bevinkbd/miscellaneous-calla/README.md

# miscellaneous-calla
for all your calla needs
