bevinkbd/miscellaneous-calla/plates/custom_plates/README.md

# group buy plates

thicknesses:
MX - 1.5 mm
Topre - 1.2 mm
Alps - 1.2 mm

sanity check:
346.125 mm x 129.325 mm for all plates

before you proceed please note: files are provided as is. these files are made by request and have not been prototyped. ensure that the layout and orientation of your keys/stabilizers are correct. use at your own risk.

if you are unsure about the compatibility of a file, I would be more than glad to help.
