bevinkbd/miscellaneous-calla/plates/group_buy_plates/README.md

# group buy plates

metal MX - 1.5 mm 5053 aluminium
plastic MX - 1.5 mm polypropylene
metal Topre - 1.2 mm stainless steel. WARNING: requires 43x M2 tapped holes.

sanity check:
346.125 mm x 129.325 mm for all plates
