bevinkbd/miscellaneous-calla/misc/foam.dxf

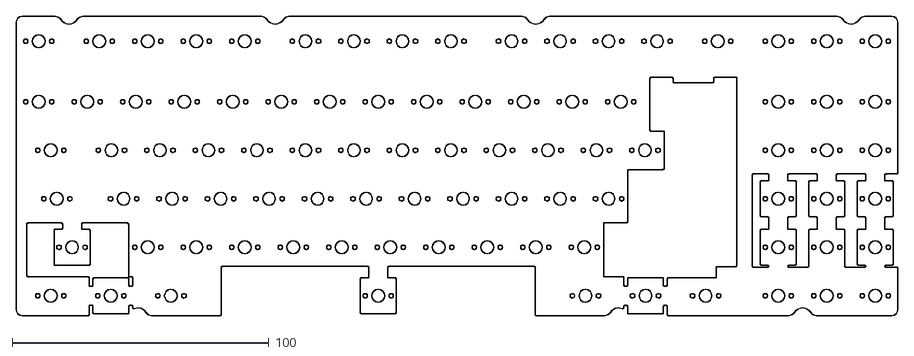
[picture p1: CAD file, 2024-04-25]
misc/foam.dxf
343.6 x 116.6
