bevinkbd/miscellaneous-calla/plates/custom_plates/alps/alps_2023_08_19_splitrs+split_bs.dxf

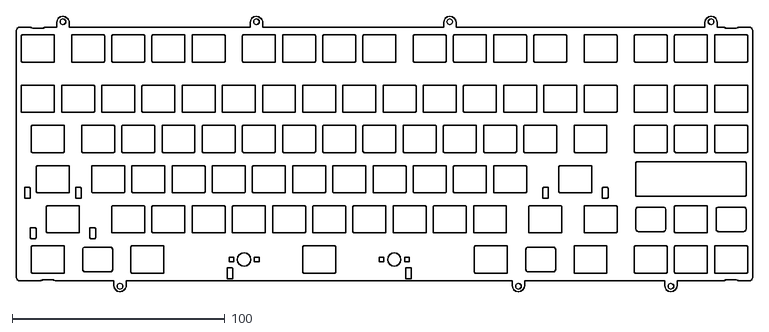
[picture p2: CAD file, 2024-04-28]
plates/custom_plates/alps/alps_2023_08_19_splitrs+split_bs.dxf
346.1 x 129.3
