bevinkbd/miscellaneous-calla/plates/custom_plates/topre/metal_topre_2023_08_19_splitBS+splitRS.dxf

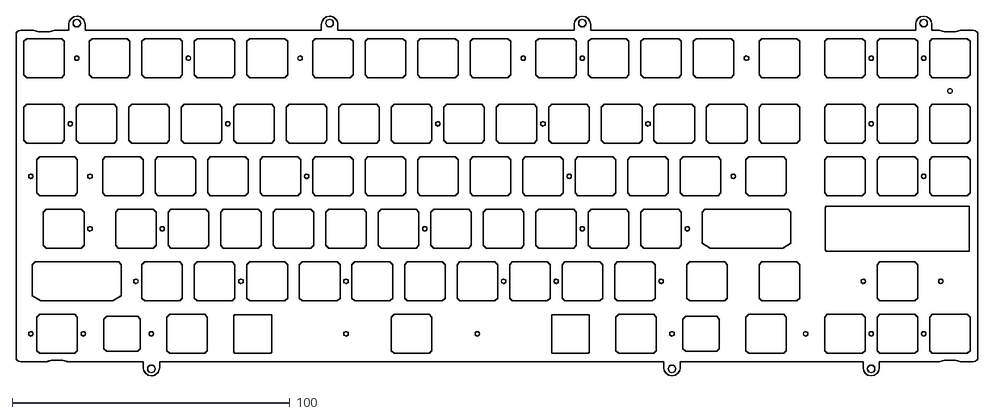
[picture p3: CAD file, 2024-04-28]
plates/custom_plates/topre/metal_topre_2023_08_19_splitBS+splitRS.dxf
346.1 x 129.3
