bevinkbd/miscellaneous-calla/plates/group_buy_plates/metal_MX_2023_08_19.dxf

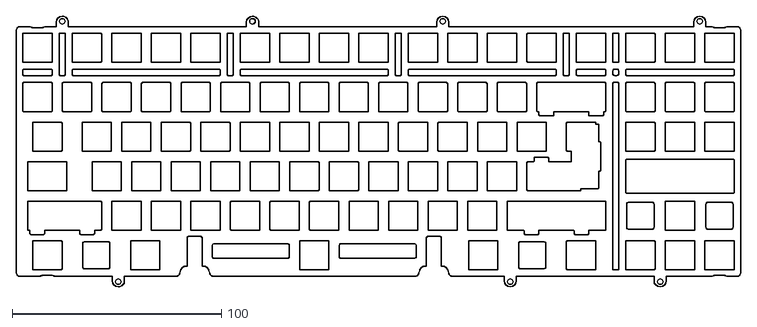
[picture p4: CAD file, 2024-04-25]
plates/group_buy_plates/metal_MX_2023_08_19.dxf
346.1 x 129.3
