bevinkbd/miscellaneous-calla/plates/custom_plates/alps/alps_2023_08_19.dxf

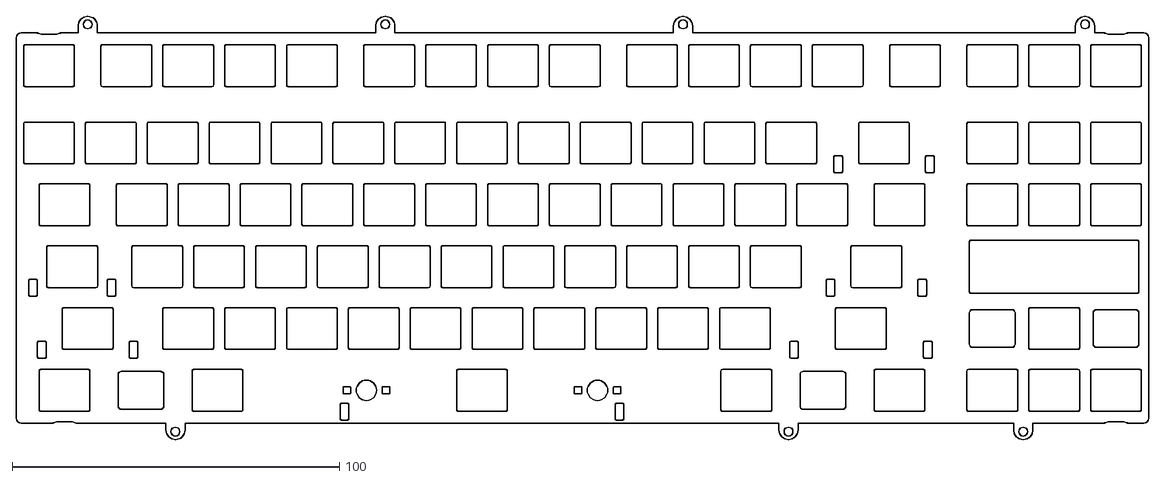
[picture p5: CAD file, 2024-04-28]
plates/custom_plates/alps/alps_2023_08_19.dxf
346.1 x 129.3
