bevinkbd/miscellaneous-calla/plates/custom_plates/topre/metal_topre_2023_08_19_splitBS.dxf

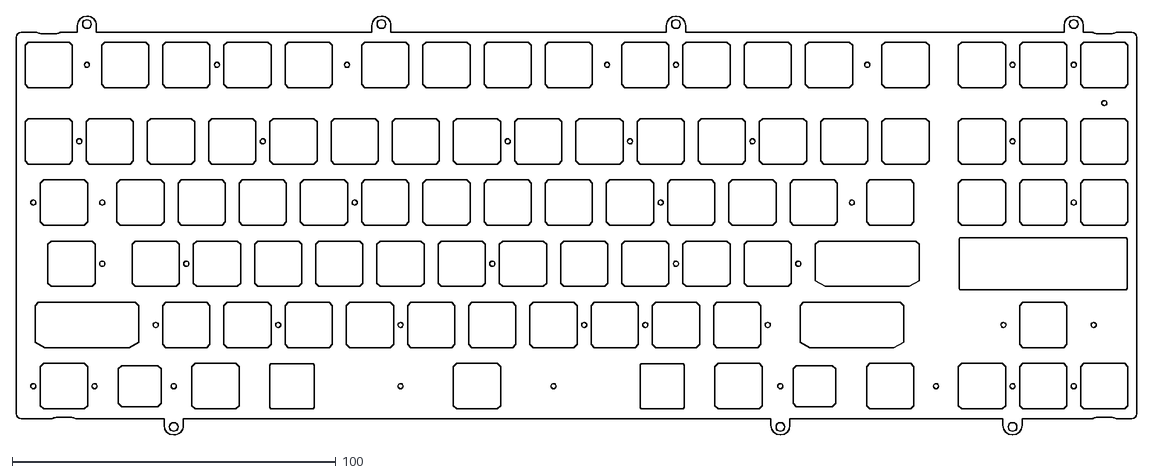
[picture p6: CAD file, 2024-04-28]
plates/custom_plates/topre/metal_topre_2023_08_19_splitBS.dxf
346.1 x 129.3
