bevinkbd/miscellaneous-calla/pcbs/eccalla/EC_Rev2.kicad_sch

## KiCad design pcbs/eccalla/EC_Rev2.kicad_sch (2024-04-25)

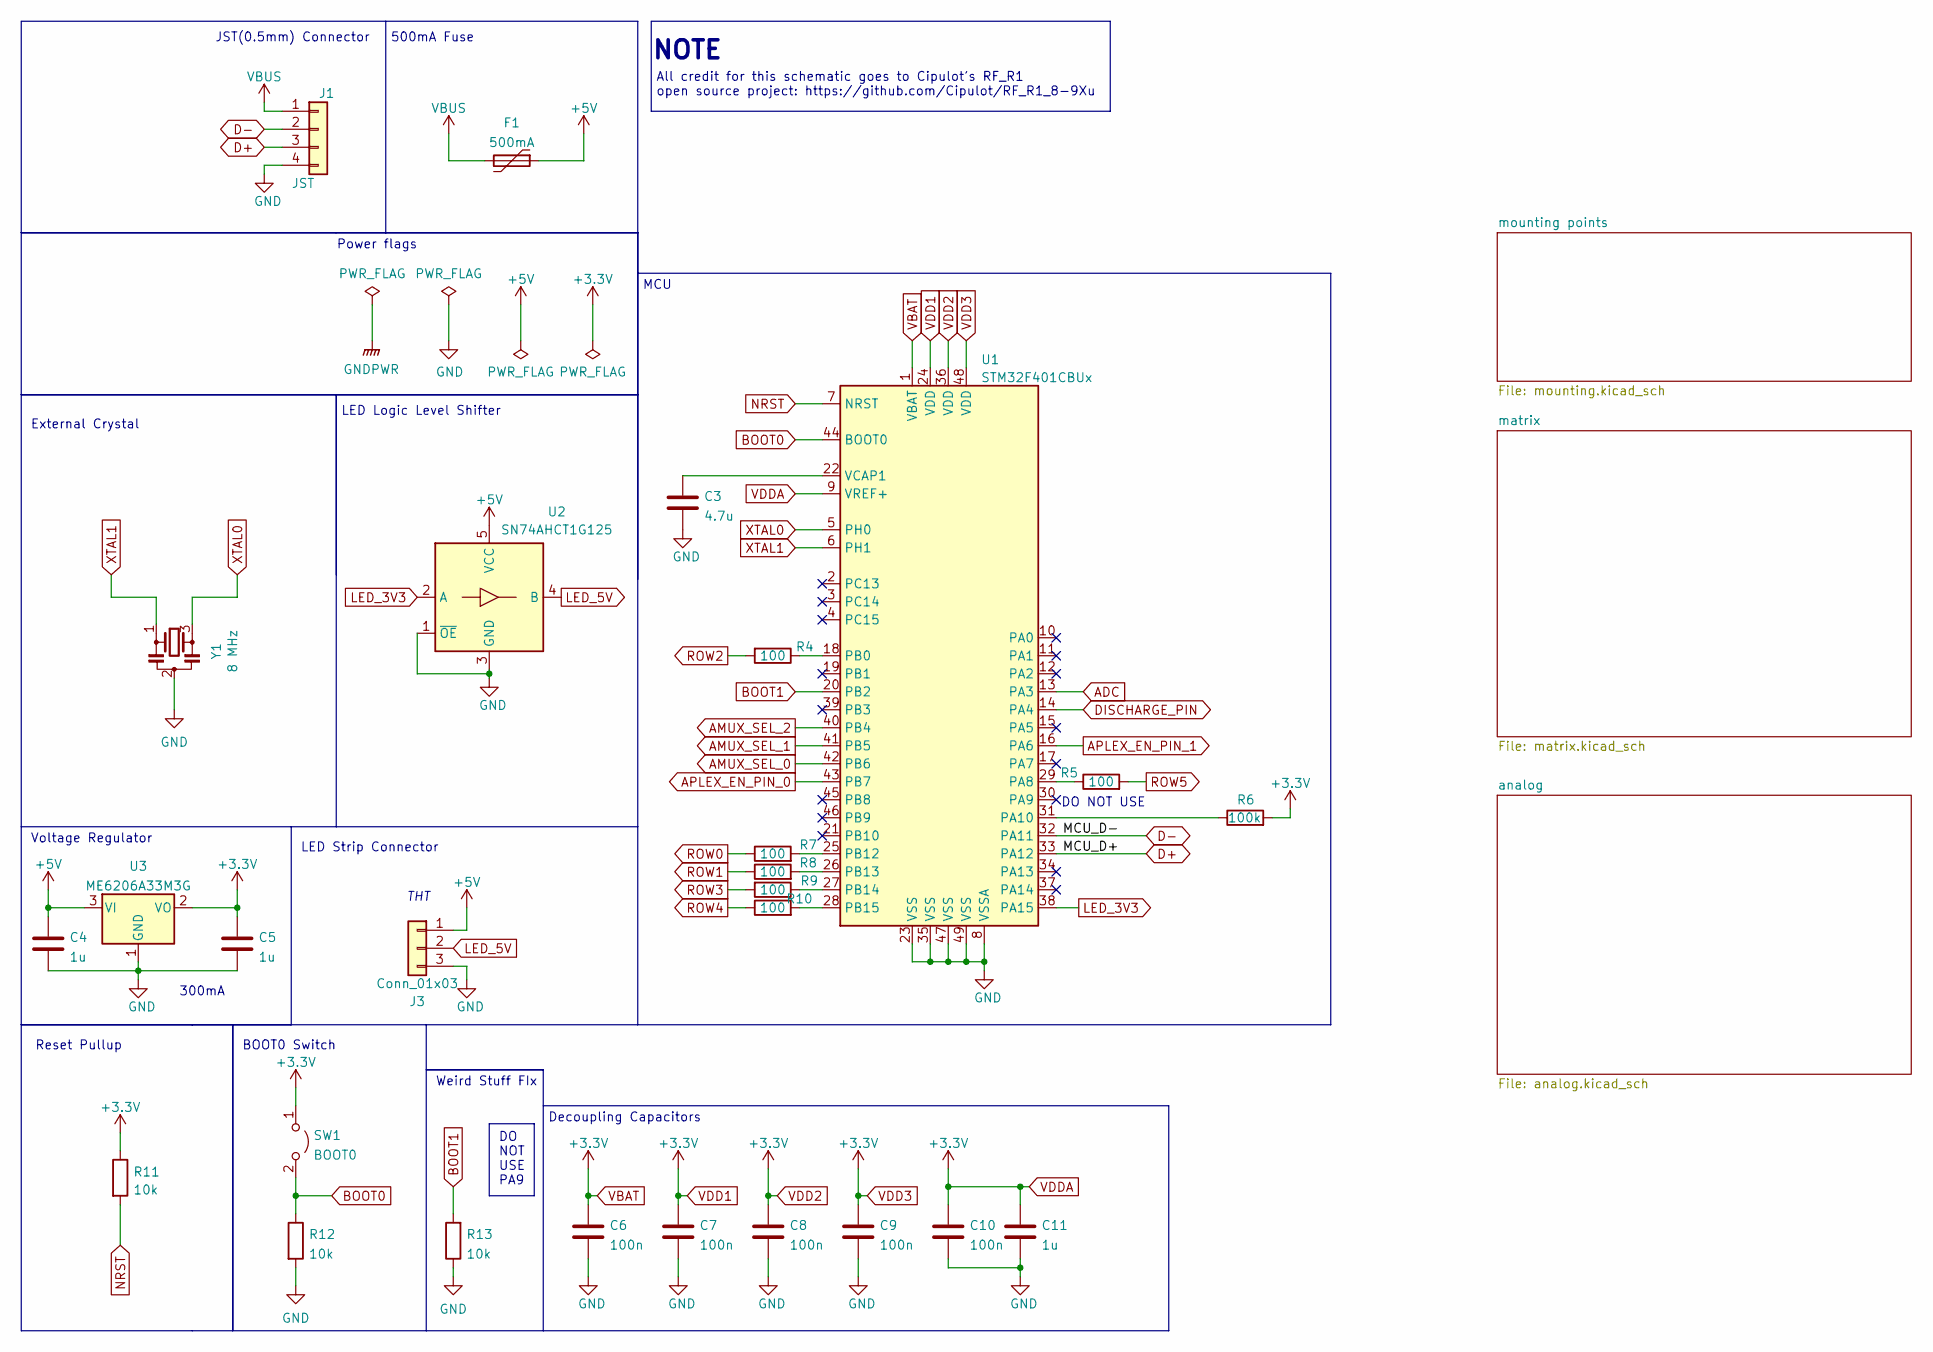
[picture p15: schematic EC_Rev2.kicad_sch]

Parts:
C3: 4.7u; C_0402_1005Metric; LCSC C23733
C4, C5, C11: 1u; C_0402_1005Metric; LCSC C52923
C6, C7, C8, C9, C10: 100n; C_0402_1005Metric; LCSC C307331
F1: 500mA; Fuse_1206_3216Metric; LCSC C70076
J1: JST; JST-SR-4; LCSC C145956
J3: Conn_01x03; PinHeader_1x03_P2.54mm_Vertical
R4, R5, R7, R8, R9, R10: 100; R_0402_1005Metric; LCSC C25076
R6: 100k; R_0402_1005Metric; LCSC C25741
R11, R12, R13: 10k; R_0402_1005Metric; LCSC C25744
SW1: BOOT0; PinHeader_1x02_P1.27mm_Vertical
U1: STM32F401CBUx; QFN-48-1EP_7x7mm_P0.5mm_EP5.6x5.6mm; LCSC C118825
U2: SN74AHCT1G125; SOT-23-5; LCSC C7484
U3: ME6206A33M3G; SOT-23; LCSC C35259
Y1: 8 MHz; Resonator_SMD_Murata_CSTxExxV-3Pin_3.0x1.1mm; LCSC C907975

Connections:
+3.3V: C5.1, C6.1, C7.1, C8.1, C9.1, C10.1, C11.1, R6.2, R11.1, SW1.1 (A), U1.1 (VBAT), U1.9 (VREF+), U1.24 (VDD), U1.36 (VDD), U1.48 (VDD), U3.2 (VO)
+5V: C4.1, F1.1, J3.1, U2.5 (VCC), U3.3 (VI)
ADC: U1.13 (PA3)
AMUX_SEL_0: U1.42 (PB6)
AMUX_SEL_1: U1.41 (PB5)
AMUX_SEL_2: U1.40 (PB4)
APLEX_EN_PIN_0: U1.43 (PB7)
APLEX_EN_PIN_1: U1.16 (PA6)
BOOT0: R12.1, SW1.2 (B), U1.44 (BOOT0)
BOOT1: R13.2, U1.20 (PB2)
D+: J1.3, U1.33 (PA12)
D-: J1.2, U1.32 (PA11)
DISCHARGE_PIN: U1.14 (PA4)
GND: C3.2, C4.2, C5.2, C6.2, C7.2, C8.2, C9.2, C10.2, C11.2, J1.4, J3.3, R12.2, R13.1, U1.8 (VSSA), U1.23 (VSS), U1.35 (VSS), U1.47 (VSS), U1.49 (VSS), U2.1 (~OE), U2.3 (GND), U3.1 (GND), Y1.2
LED_3V3: U1.38 (PA15), U2.2 (A)
LED_5V: J3.2, U2.4 (B)
NRST: R11.2, U1.7 (NRST)
unnamed: C3.1, U1.22 (VCAP1)
unnamed: R4.1, U1.18 (PB0)
unnamed: R5.1, U1.29 (PA8)
unnamed: R6.1, U1.31 (PA10)
unnamed: R7.2, U1.25 (PB12)
unnamed: R8.2, U1.26 (PB13)
unnamed: R9.1, U1.27 (PB14)
unnamed: R10.2, U1.28 (PB15)
ROW0: R7.1
ROW1: R8.1
ROW2: R4.2
ROW3: R9.2
ROW4: R10.1
ROW5: R5.2
VBUS: F1.2, J1.1
XTAL0: U1.5 (PH0), Y1.3
XTAL1: U1.6 (PH1), Y1.1

Notes on the sheet:
LED Strip Connector
300mA
Weird Stuff FIx
JST(0.5mm) Connector
Decoupling Capacitors
MCU
THT
All credit for this schematic goes to Cipulot's RF_R1 open source project: https://github.com/Cipulot/RF_R1_8-9Xu
DO NOT USE PA9
External Crystal
500mA Fuse
NOTE
Power flags
Voltage Regulator
BOOT0 Switch
LED Logic Level Shifter
Reset Pullup
DO NOT USE
