bevinkbd/miscellaneous-calla/pcbs/eccalla/analog.kicad_sch

## KiCad design pcbs/eccalla/analog.kicad_sch (2024-04-25)

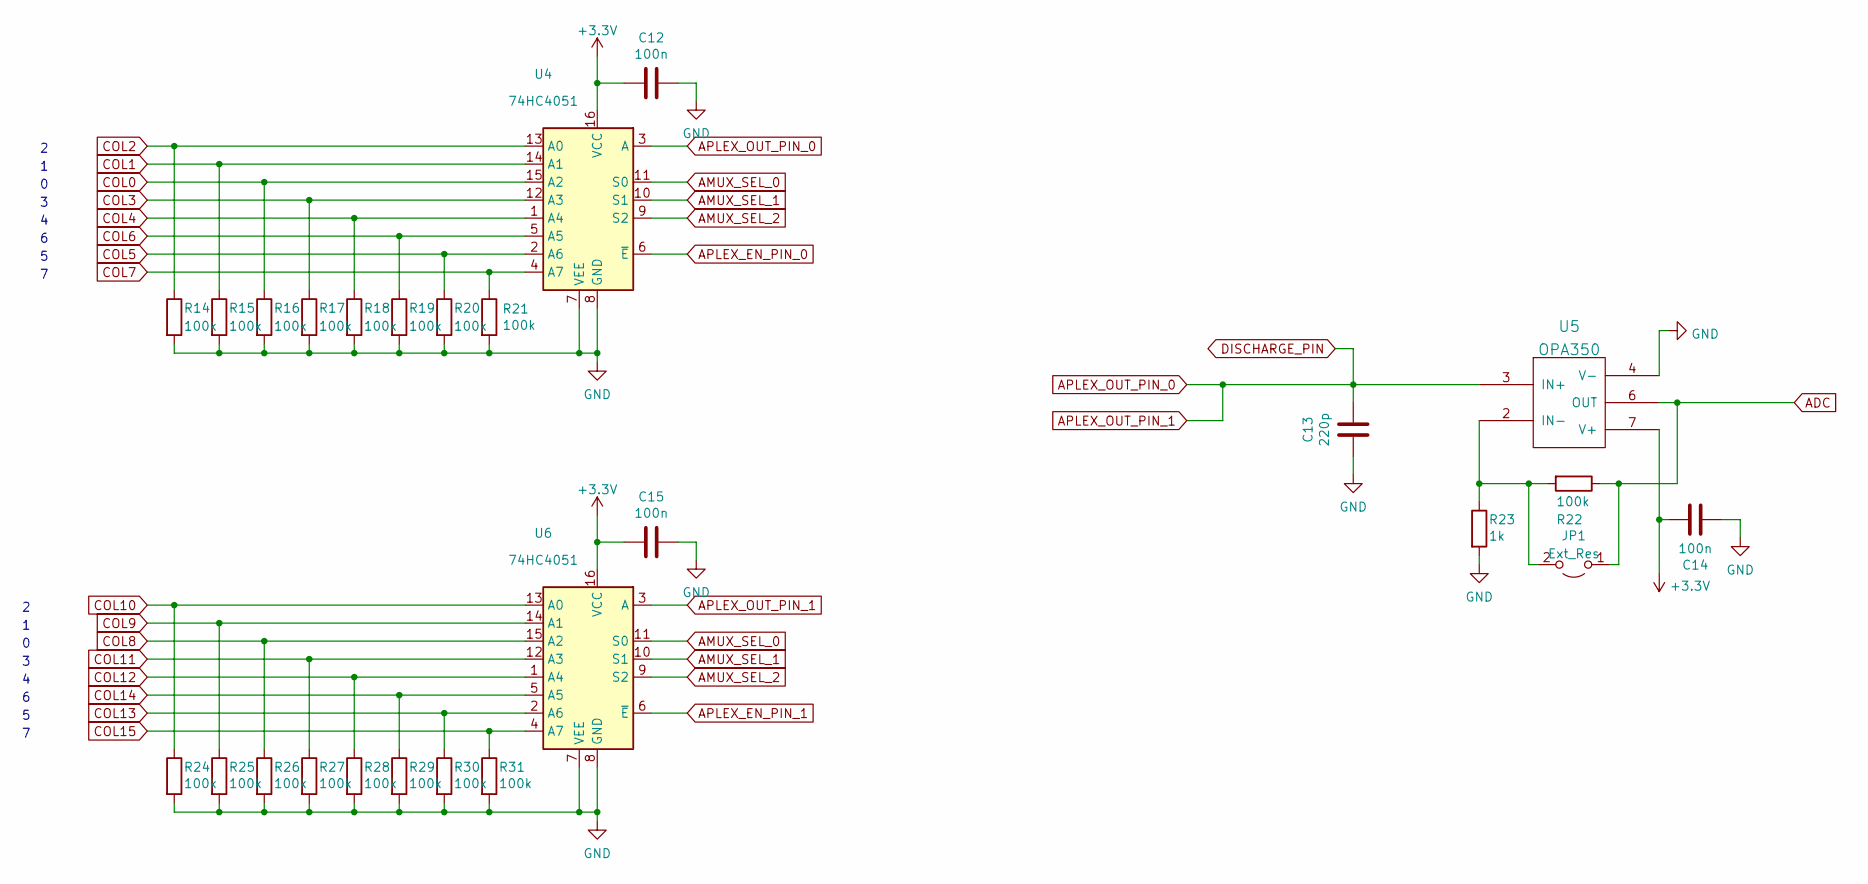
[picture p16: schematic analog.kicad_sch]

Parts:
C12, C14, C15: 100n; C_0402_1005Metric; LCSC C307331
C13: 220p; C_0603_1608Metric; LCSC C1603
JP1: Ext_Res; R_0603_1608Metric
R14, R15, R16, R17, R18, R19, R20, R21, R24, R25, R26, R27, R28, R29, R30, R31: 100k; R_0402_1005Metric; LCSC C25741
R22: 100k; R_0603_1608Metric; LCSC C25803
R23: 1k; R_0603_1608Metric; LCSC C21190
U4, U6: 74HC4051; TSSOP16; LCSC C5645
U5: OPA350; SOIC-8_3.9x4.9mm_P1.27mm; LCSC C13388

Connections:
+3.3V: C12.2, C14.2, C15.2, U4.16 (VCC), U5.7 (V+), U6.16 (VCC)
ADC: JP1.1 (A), R22.1, U5.6 (OUT)
AMUX_SEL_0: U4.11 (S0), U6.11 (S0)
AMUX_SEL_1: U4.10 (S1), U6.10 (S1)
AMUX_SEL_2: U4.9 (S2), U6.9 (S2)
APLEX_EN_PIN_0: U4.6 (~E)
APLEX_EN_PIN_1: U6.6 (~E)
APLEX_OUT_PIN_0: C13.1, U4.3 (A), U5.3 (IN+), U6.3 (A)
COL0: R16.1, U4.15 (A2)
COL1: R15.1, U4.14 (A1)
COL2: R14.1, U4.13 (A0)
COL3: R17.1, U4.12 (A3)
COL4: R18.1, U4.1 (A4)
COL5: R20.1, U4.2 (A6)
COL6: R19.1, U4.5 (A5)
COL7: R21.1, U4.4 (A7)
COL8: R26.1, U6.15 (A2)
COL9: R25.1, U6.14 (A1)
COL10: R24.1, U6.13 (A0)
COL11: R27.1, U6.12 (A3)
COL12: R28.1, U6.1 (A4)
COL13: R30.1, U6.2 (A6)
COL14: R29.1, U6.5 (A5)
COL15: R31.1, U6.4 (A7)
GND: C12.1, C13.2, C14.1, C15.1, R14.2, R15.2, R16.2, R17.2, R18.2, R19.2, R20.2, R21.2, R23.2, R24.2, R25.2, R26.2, R27.2, R28.2, R29.2, R30.2, R31.2, U4.7 (VEE), U4.8 (GND), U5.4 (V-), U6.7 (VEE), U6.8 (GND)
unnamed: JP1.2 (B), R22.2, R23.1, U5.2 (IN-)
