bevinkbd/miscellaneous-calla/pcbs/eccalla/matrix.kicad_sch

## KiCad design pcbs/eccalla/matrix.kicad_sch (2024-04-25)

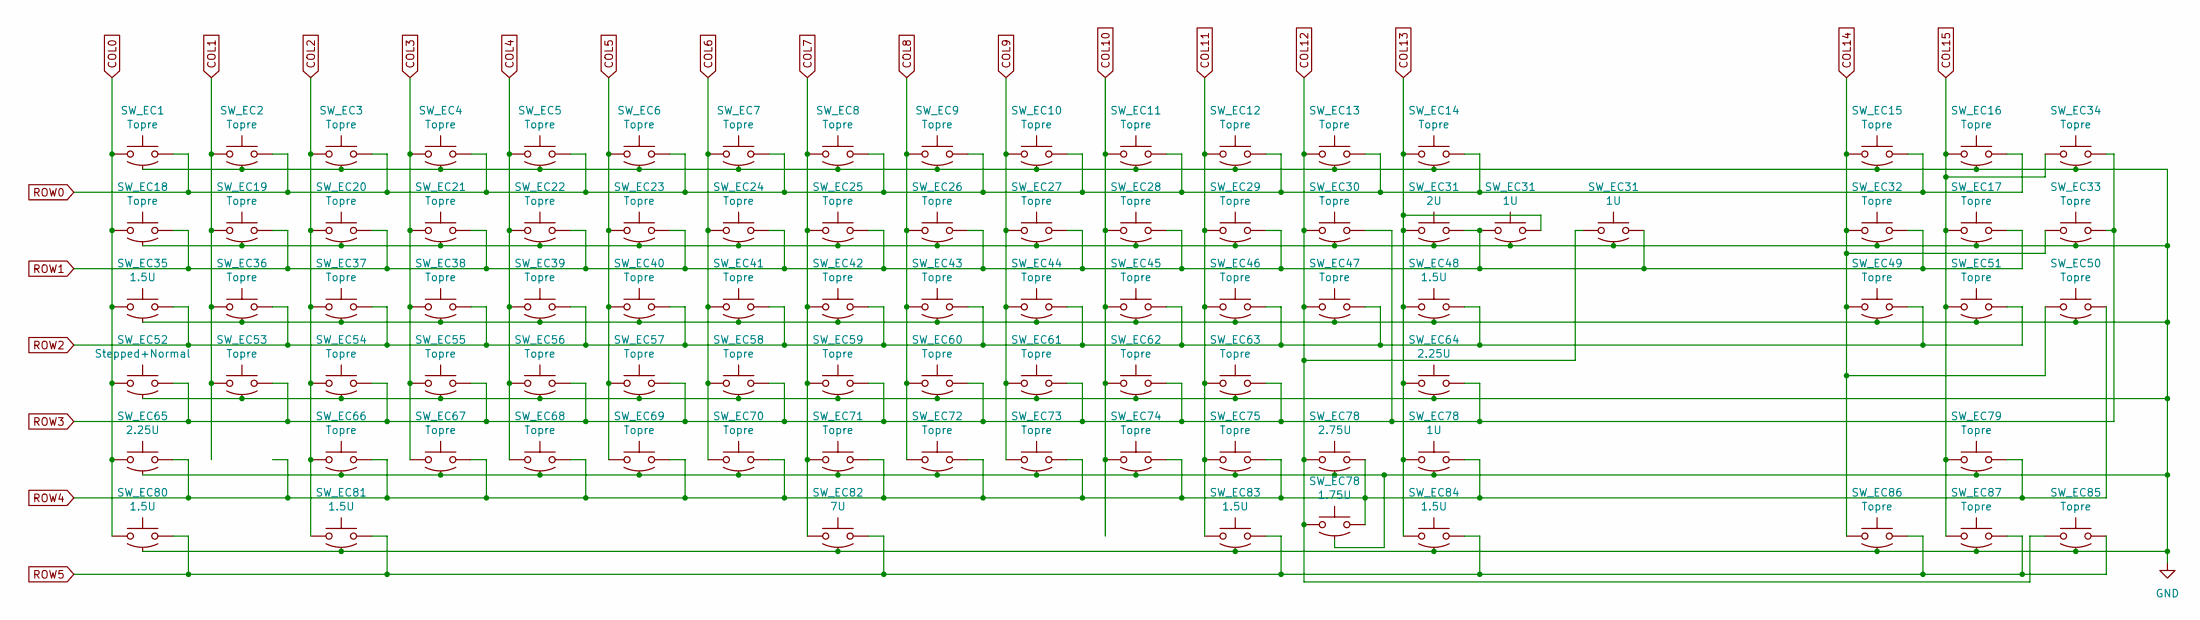
[picture p17: schematic matrix.kicad_sch]

Parts:
SW_EC1, SW_EC2, SW_EC3, SW_EC4, SW_EC5, SW_EC6, SW_EC7, SW_EC8, SW_EC9, SW_EC10, SW_EC11, SW_EC12, SW_EC13, SW_EC14, SW_EC15, SW_EC16, SW_EC17, SW_EC18, SW_EC19, SW_EC20, SW_EC21, SW_EC22, SW_EC23, SW_EC24, SW_EC25, SW_EC26, SW_EC27, SW_EC28, SW_EC29, SW_EC30, SW_EC32, SW_EC33, SW_EC34, SW_EC36, SW_EC37, SW_EC38, SW_EC39, SW_EC40, SW_EC41, SW_EC42, SW_EC43, SW_EC44, SW_EC45, SW_EC46, SW_EC47, SW_EC49, SW_EC50, SW_EC51, SW_EC53, SW_EC54, SW_EC55, SW_EC56, SW_EC57, SW_EC58, SW_EC59, SW_EC60, SW_EC61, SW_EC62, SW_EC63, SW_EC66, SW_EC67, SW_EC68, SW_EC69, SW_EC70, SW_EC71, SW_EC72, SW_EC73, SW_EC74, SW_EC75, SW_EC79, SW_EC85, SW_EC86, SW_EC87: Topre; ecs_pad_1U_no_ring
SW_EC31, SW_EC78: 1U; ecs_pad_1U_no_ring
SW_EC35, SW_EC48, SW_EC80, SW_EC81, SW_EC83, SW_EC84: 1.5U; ecs_pad_1.5U_no_ring
SW_EC52: Stepped+Normal; ecs_pad_no_ring_stepped&normal
SW_EC64, SW_EC65: 2.25U; ecs_pad_2.25U_no_ring
SW_EC82: 7U; ecs_pad_7U_no_ring

Connections:
COL0: SW_EC1.1, SW_EC18.1, SW_EC35.1, SW_EC52.1, SW_EC65.1, SW_EC80.1
COL1: SW_EC2.1, SW_EC19.1, SW_EC36.1, SW_EC53.1
COL2: SW_EC3.1, SW_EC20.1, SW_EC37.1, SW_EC54.1, SW_EC66.1, SW_EC81.1
COL3: SW_EC4.1, SW_EC21.1, SW_EC38.1, SW_EC55.1, SW_EC67.1
COL4: SW_EC5.1, SW_EC22.1, SW_EC39.1, SW_EC56.1, SW_EC68.1
COL5: SW_EC6.1, SW_EC23.1, SW_EC40.1, SW_EC57.1, SW_EC69.1
COL6: SW_EC7.1, SW_EC24.1, SW_EC41.1, SW_EC58.1, SW_EC70.1
COL7: SW_EC8.1, SW_EC25.1, SW_EC42.1, SW_EC59.1, SW_EC71.1, SW_EC82.1
COL8: SW_EC9.1, SW_EC26.1, SW_EC43.1, SW_EC60.1, SW_EC72.1
COL9: SW_EC10.1, SW_EC27.1, SW_EC44.1, SW_EC61.1, SW_EC73.1
COL10: SW_EC11.1, SW_EC28.1, SW_EC45.1, SW_EC62.1, SW_EC74.1
COL11: SW_EC12.1, SW_EC29.1, SW_EC46.1, SW_EC63.1, SW_EC75.1, SW_EC83.1
COL12: SW_EC13.1, SW_EC30.1, SW_EC31.1, SW_EC47.1, SW_EC78.1, SW_EC85.1
COL13: SW_EC14.1, SW_EC31.1, SW_EC31.2, SW_EC48.1, SW_EC64.1, SW_EC78.1, SW_EC84.1
COL14: SW_EC15.1, SW_EC32.1, SW_EC33.1, SW_EC49.1, SW_EC50.1, SW_EC86.1
COL15: SW_EC16.1, SW_EC17.1, SW_EC34.1, SW_EC51.1, SW_EC79.1, SW_EC87.1
GND: SW_EC1.3, SW_EC2.3, SW_EC3.3, SW_EC4.3, SW_EC5.3, SW_EC6.3, SW_EC7.3, SW_EC8.3, SW_EC9.3, SW_EC10.3, SW_EC11.3, SW_EC12.3, SW_EC13.3, SW_EC14.3, SW_EC15.3, SW_EC16.3, SW_EC17.3, SW_EC18.3, SW_EC19.3, SW_EC20.3, SW_EC21.3, SW_EC22.3, SW_EC23.3, SW_EC24.3, SW_EC25.3, SW_EC26.3, SW_EC27.3, SW_EC28.3, SW_EC29.3, SW_EC30.3, SW_EC31.3, SW_EC32.3, SW_EC33.3, SW_EC34.3, SW_EC35.3, SW_EC36.3, SW_EC37.3, SW_EC38.3, SW_EC39.3, SW_EC40.3, SW_EC41.3, SW_EC42.3, SW_EC43.3, SW_EC44.3, SW_EC45.3, SW_EC46.3, SW_EC47.3, SW_EC48.3, SW_EC49.3, SW_EC50.3, SW_EC51.3, SW_EC52.3, SW_EC53.3, SW_EC54.3, SW_EC55.3, SW_EC56.3, SW_EC57.3, SW_EC58.3, SW_EC59.3, SW_EC60.3, SW_EC61.3, SW_EC62.3, SW_EC63.3, SW_EC64.3, SW_EC65.3, SW_EC66.3, SW_EC67.3, SW_EC68.3, SW_EC69.3, SW_EC70.3, SW_EC71.3, SW_EC72.3, SW_EC73.3, SW_EC74.3, SW_EC75.3, SW_EC78.3, SW_EC79.3, SW_EC80.3, SW_EC81.3, SW_EC82.3, SW_EC83.3, SW_EC84.3, SW_EC85.3, SW_EC86.3, SW_EC87.3
ROW0: SW_EC1.2, SW_EC2.2, SW_EC3.2, SW_EC4.2, SW_EC5.2, SW_EC6.2, SW_EC7.2, SW_EC8.2, SW_EC9.2, SW_EC10.2, SW_EC11.2, SW_EC12.2, SW_EC13.2, SW_EC14.2, SW_EC15.2, SW_EC16.2
ROW1: SW_EC17.2, SW_EC18.2, SW_EC19.2, SW_EC20.2, SW_EC21.2, SW_EC22.2, SW_EC23.2, SW_EC24.2, SW_EC25.2, SW_EC26.2, SW_EC27.2, SW_EC28.2, SW_EC29.2, SW_EC31.1, SW_EC31.2, SW_EC32.2
ROW2: SW_EC35.2, SW_EC36.2, SW_EC37.2, SW_EC38.2, SW_EC39.2, SW_EC40.2, SW_EC41.2, SW_EC42.2, SW_EC43.2, SW_EC44.2, SW_EC45.2, SW_EC46.2, SW_EC47.2, SW_EC48.2, SW_EC49.2, SW_EC51.2
ROW3: SW_EC30.2, SW_EC33.2, SW_EC34.2, SW_EC52.2, SW_EC53.2, SW_EC54.2, SW_EC55.2, SW_EC56.2, SW_EC57.2, SW_EC58.2, SW_EC59.2, SW_EC60.2, SW_EC61.2, SW_EC62.2, SW_EC63.2, SW_EC64.2
ROW4: SW_EC50.2, SW_EC65.2, SW_EC66.2, SW_EC67.2, SW_EC68.2, SW_EC69.2, SW_EC70.2, SW_EC71.2, SW_EC72.2, SW_EC73.2, SW_EC74.2, SW_EC75.2, SW_EC78.2, SW_EC79.2
ROW5: SW_EC80.2, SW_EC81.2, SW_EC82.2, SW_EC83.2, SW_EC84.2, SW_EC85.2, SW_EC86.2, SW_EC87.2
