bevinkbd/miscellaneous-calla/pcbs/eccalla/mounting.kicad_sch

## KiCad design pcbs/eccalla/mounting.kicad_sch (2024-04-25)

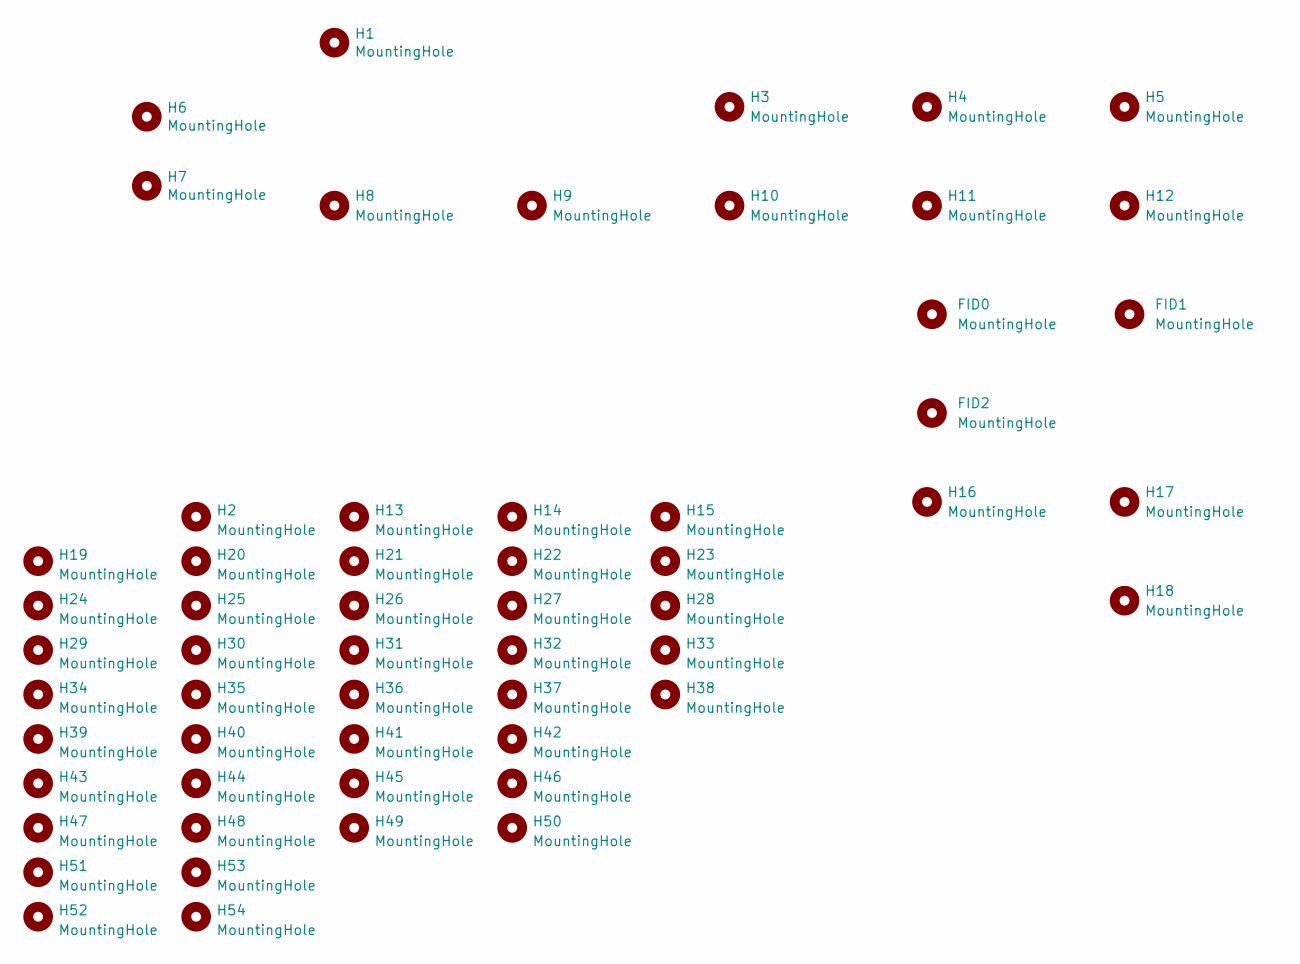
[picture p18: schematic mounting.kicad_sch]

Parts:
FID0, FID1, FID2: MountingHole; Fiducial_1.5mm_Mask3mm
H1: MountingHole; xcalla
H2, H13, H14, H15, H16, H17, H18, H19, H20, H21, H22, H23, H24, H25, H26, H27, H28, H29, H30, H31, H32, H33, H34, H35, H36, H37, H38, H39, H40, H41, H42, H43, H44, H45, H46, H47, H48, H49, H50, H51, H52, H53, H54: MountingHole; M2 screwhole
H3, H4, H5, H6, H7, H8, H9, H10, H11, H12: MountingHole; breakaway-mousebites
