bevinkbd/miscellaneous-calla/pcbs/hscalla/hscalla.kicad_sch

## KiCad design pcbs/hscalla/hscalla.kicad_sch (2024-04-25)

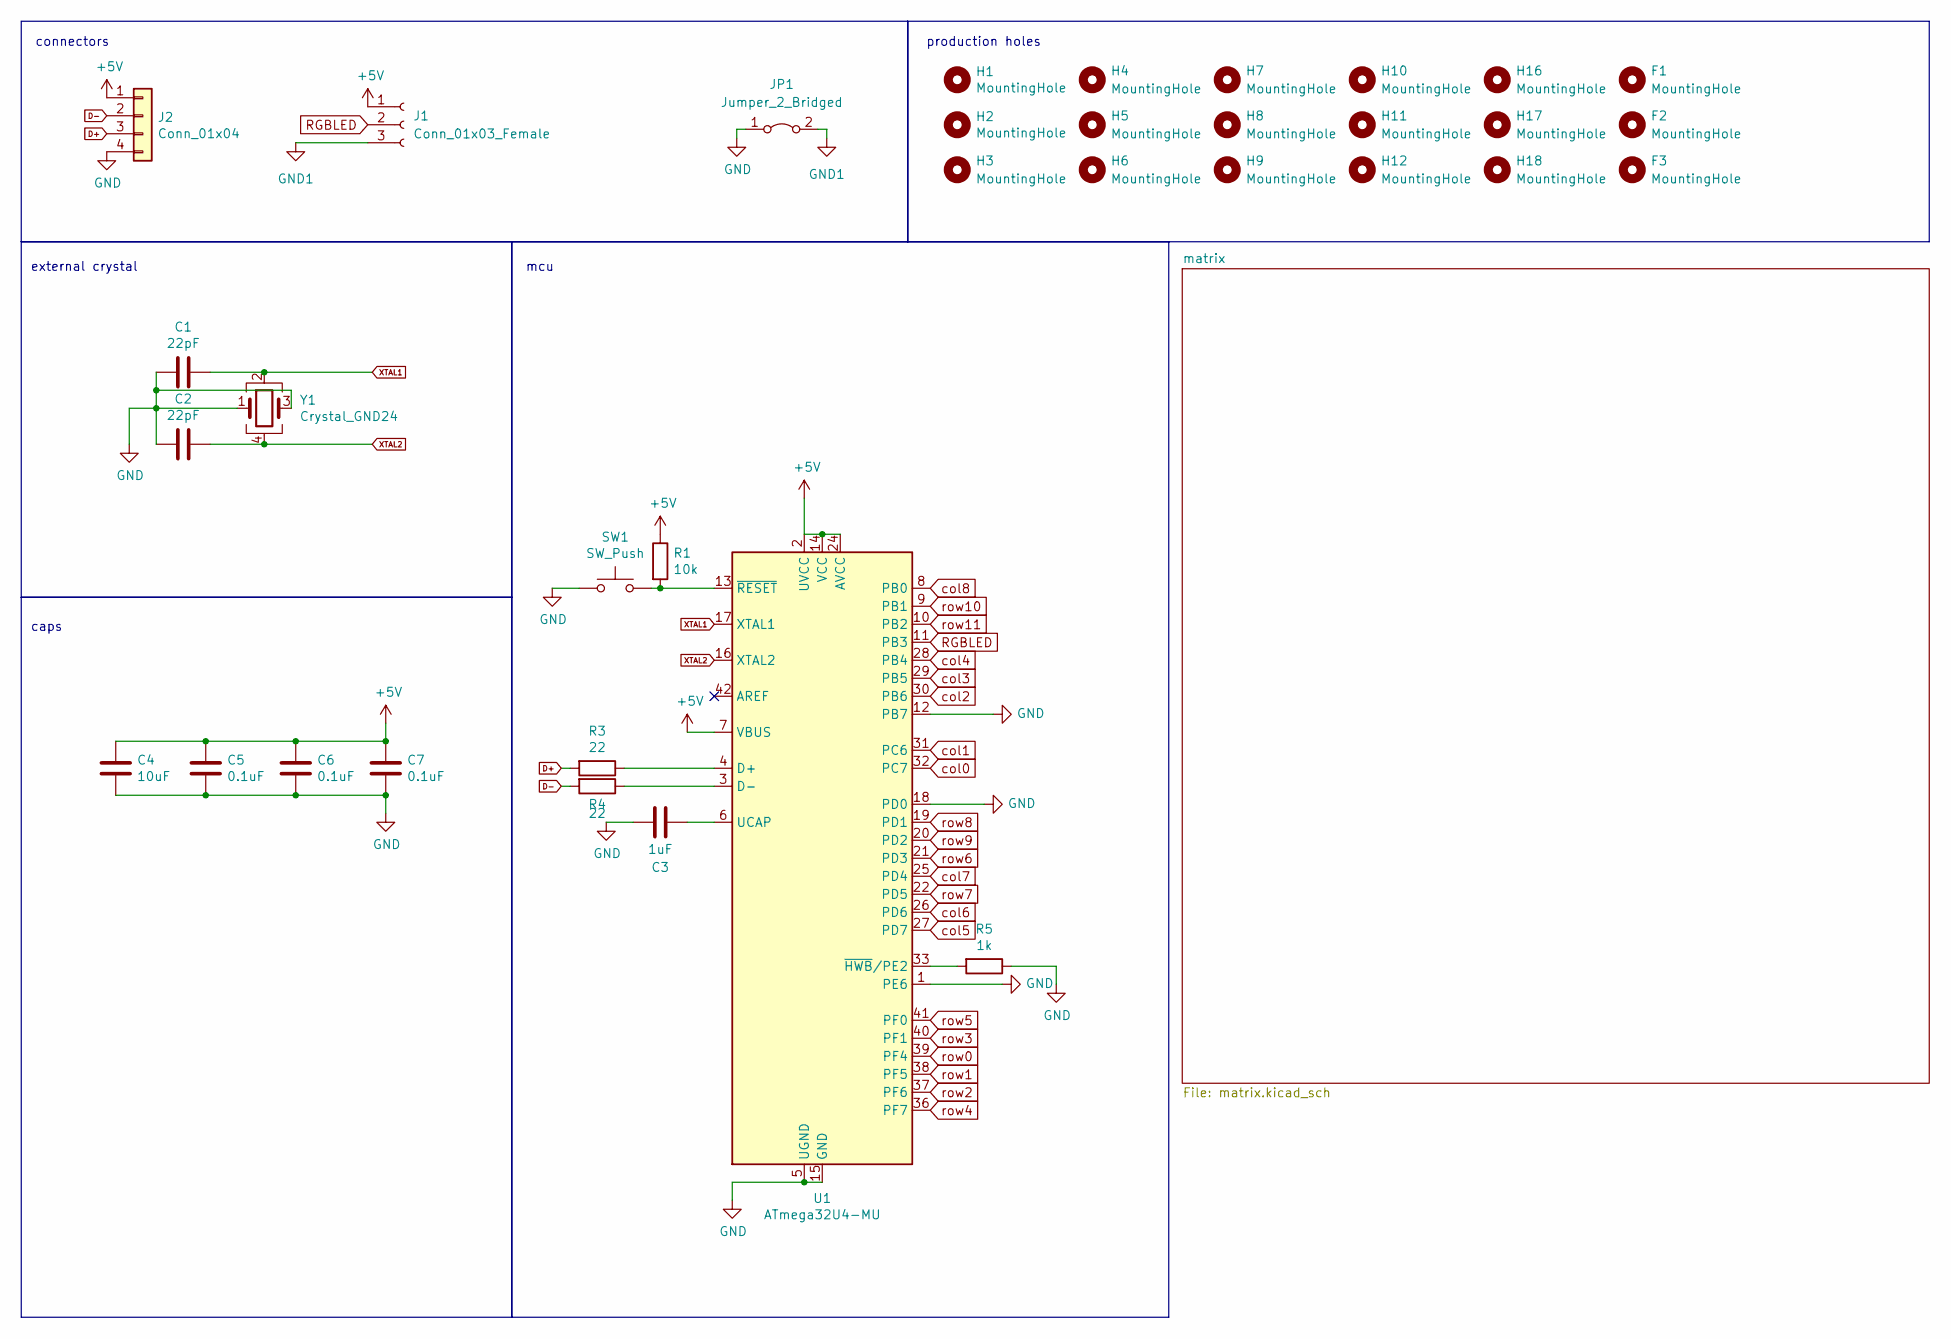
[picture p19: schematic hscalla.kicad_sch]

Parts:
C1, C2: 22pF; C_0805_2012Metric
C3: 1uF; C_0805_2012Metric
C4: 10uF; C_0805_2012Metric
C5, C6, C7: 0.1uF; C_0805_2012Metric
F1, F2, F3: MountingHole; Fiducial_1.5mm_Mask3mm
H1: MountingHole; xcalla
H2: MountingHole; text
H3, H4, H5, H6, H7, H8, H9, H10, H11, H12: MountingHole; breakaway-mousebites
H16, H17, H18: MountingHole; tooling hole
J1: Conn_01x03_Female; PinHeader_1x03_P2.54mm_Vertical
J2: Conn_01x04; JST-SR-4
JP1: Jumper_2_Bridged; NetTie-2_SMD_Pad0.5mm
R1: 10k; R_0805_2012Metric
R3, R4: 22; R_0603_1608Metric
R5: 1k; R_0805_2012Metric
SW1: SW_Push; SW_SPST_TL3342
U1: ATmega32U4-MU; QFN-44-1EP_7x7mm_P0.5mm_EP5.2x5.2mm
Y1: Crystal_GND24; Crystal_SMD_3225-4Pin_3.2x2.5mm

Connections:
+5V: C4.2, C5.2, C6.2, C7.2, J1.1, J2.1, R1.1, U1.2 (UVCC), U1.7 (VBUS), U1.14 (VCC), U1.24 (AVCC), U1.34 (VCC), U1.44 (AVCC)
D+: J2.3, R3.2
D-: J2.2, R4.2
GND: C1.2, C2.2, C3.2, C4.1, C5.1, C6.1, C7.1, J2.4, JP1.1 (A), R5.1, SW1.1, U1.1 (PE6), U1.5 (UGND), U1.12 (PB7), U1.15 (GND), U1.18 (PD0), U1.23 (GND), U1.35 (GND), U1.43 (GND), U1.45 (GND), Y1.1, Y1.3
GND1: J1.3, JP1.2 (B)
unnamed: C3.1, U1.6 (UCAP)
unnamed: R1.2, SW1.2, U1.13 (~RESET)
unnamed: R3.1, U1.4 (D+)
unnamed: R4.1, U1.3 (D-)
unnamed: R5.2, U1.33 (~HWB/PE2)
RGBLED: J1.2, U1.11 (PB3)
XTAL1: C1.1, U1.17 (XTAL1), Y1.2
XTAL2: C2.1, U1.16 (XTAL2), Y1.4
col0: U1.32 (PC7)
col1: U1.31 (PC6)
col2: U1.30 (PB6)
col3: U1.29 (PB5)
col4: U1.28 (PB4)
col5: U1.27 (PD7)
col6: U1.26 (PD6)
col7: U1.25 (PD4)
col8: U1.8 (PB0)
row0: U1.39 (PF4)
row1: U1.38 (PF5)
row2: U1.37 (PF6)
row3: U1.40 (PF1)
row4: U1.36 (PF7)
row5: U1.41 (PF0)
row6: U1.21 (PD3)
row7: U1.22 (PD5)
row8: U1.19 (PD1)
row9: U1.20 (PD2)
row10: U1.9 (PB1)
row11: U1.10 (PB2)

Notes on the sheet:
caps
connectors
production holes
mcu
external crystal
