bevinkbd/miscellaneous-calla/pcbs/hscalla/matrix.kicad_sch

## KiCad design pcbs/hscalla/matrix.kicad_sch (2024-04-25)

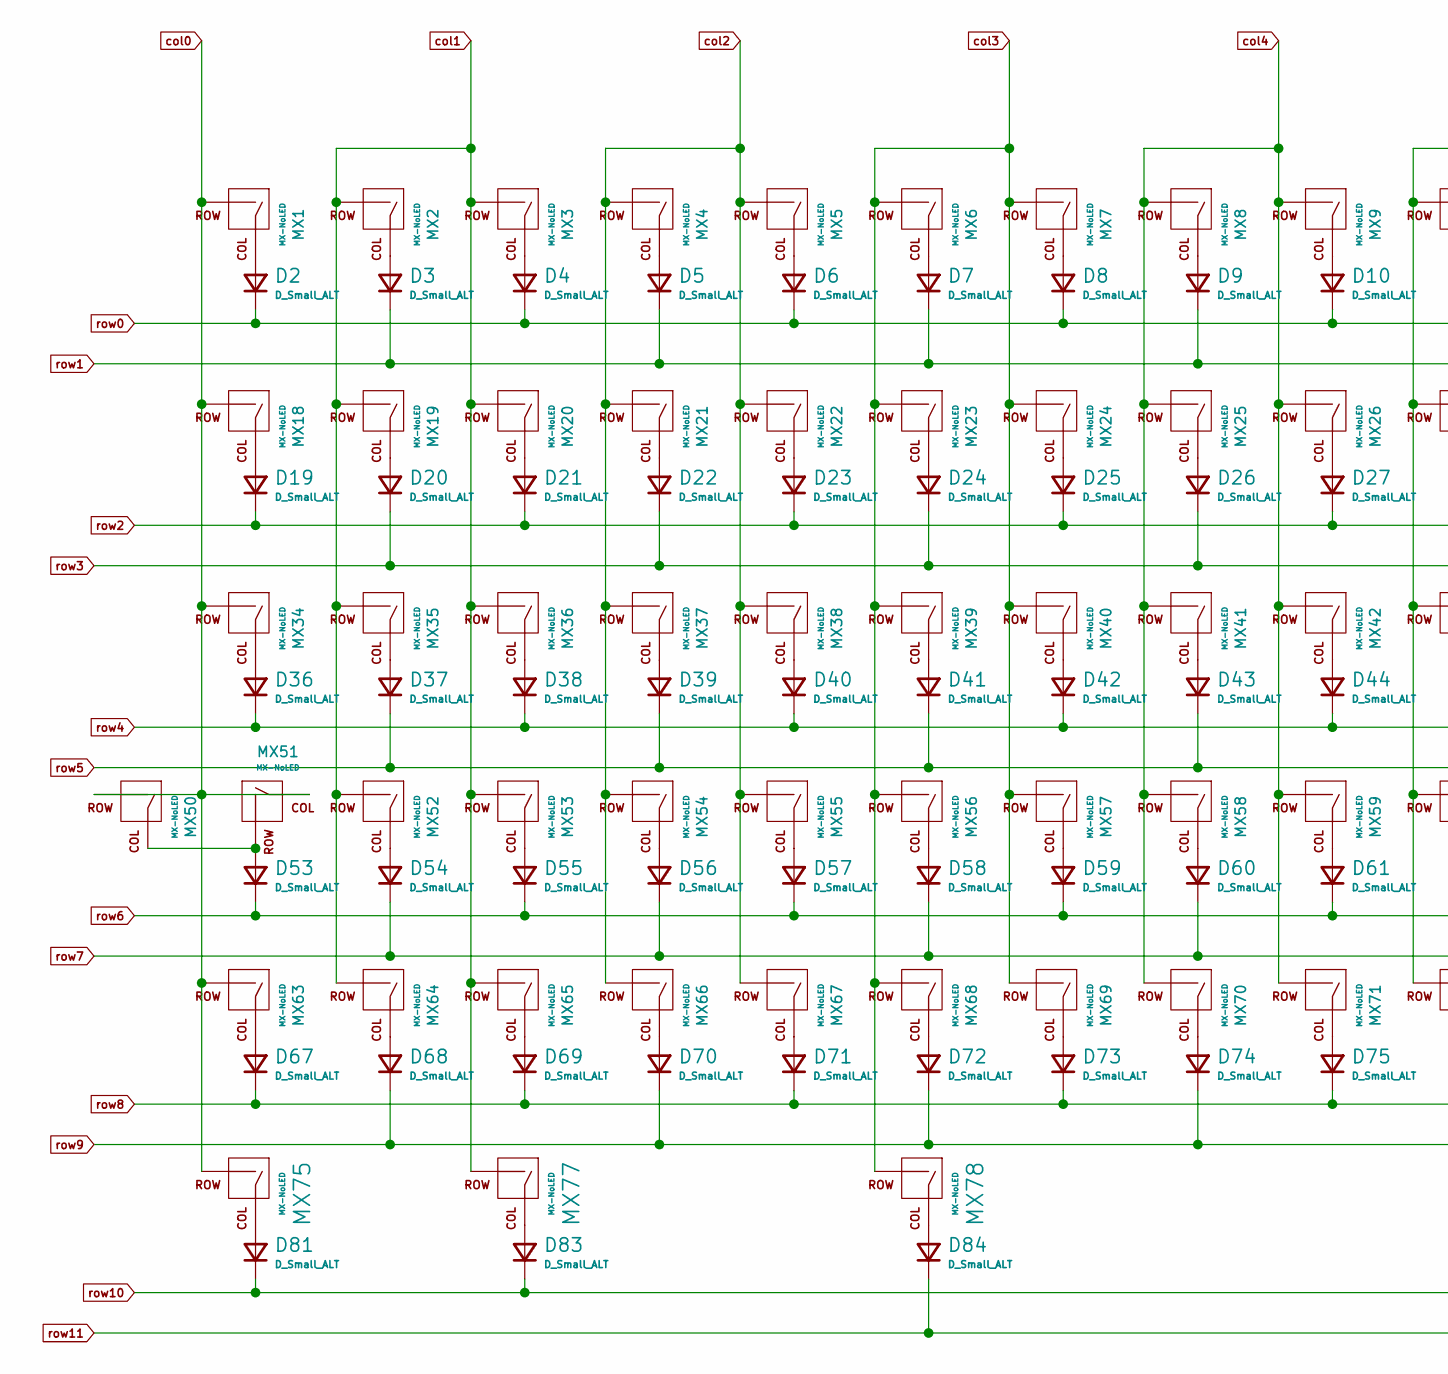
[picture p20: schematic matrix.kicad_sch, part in row 1, column 1]

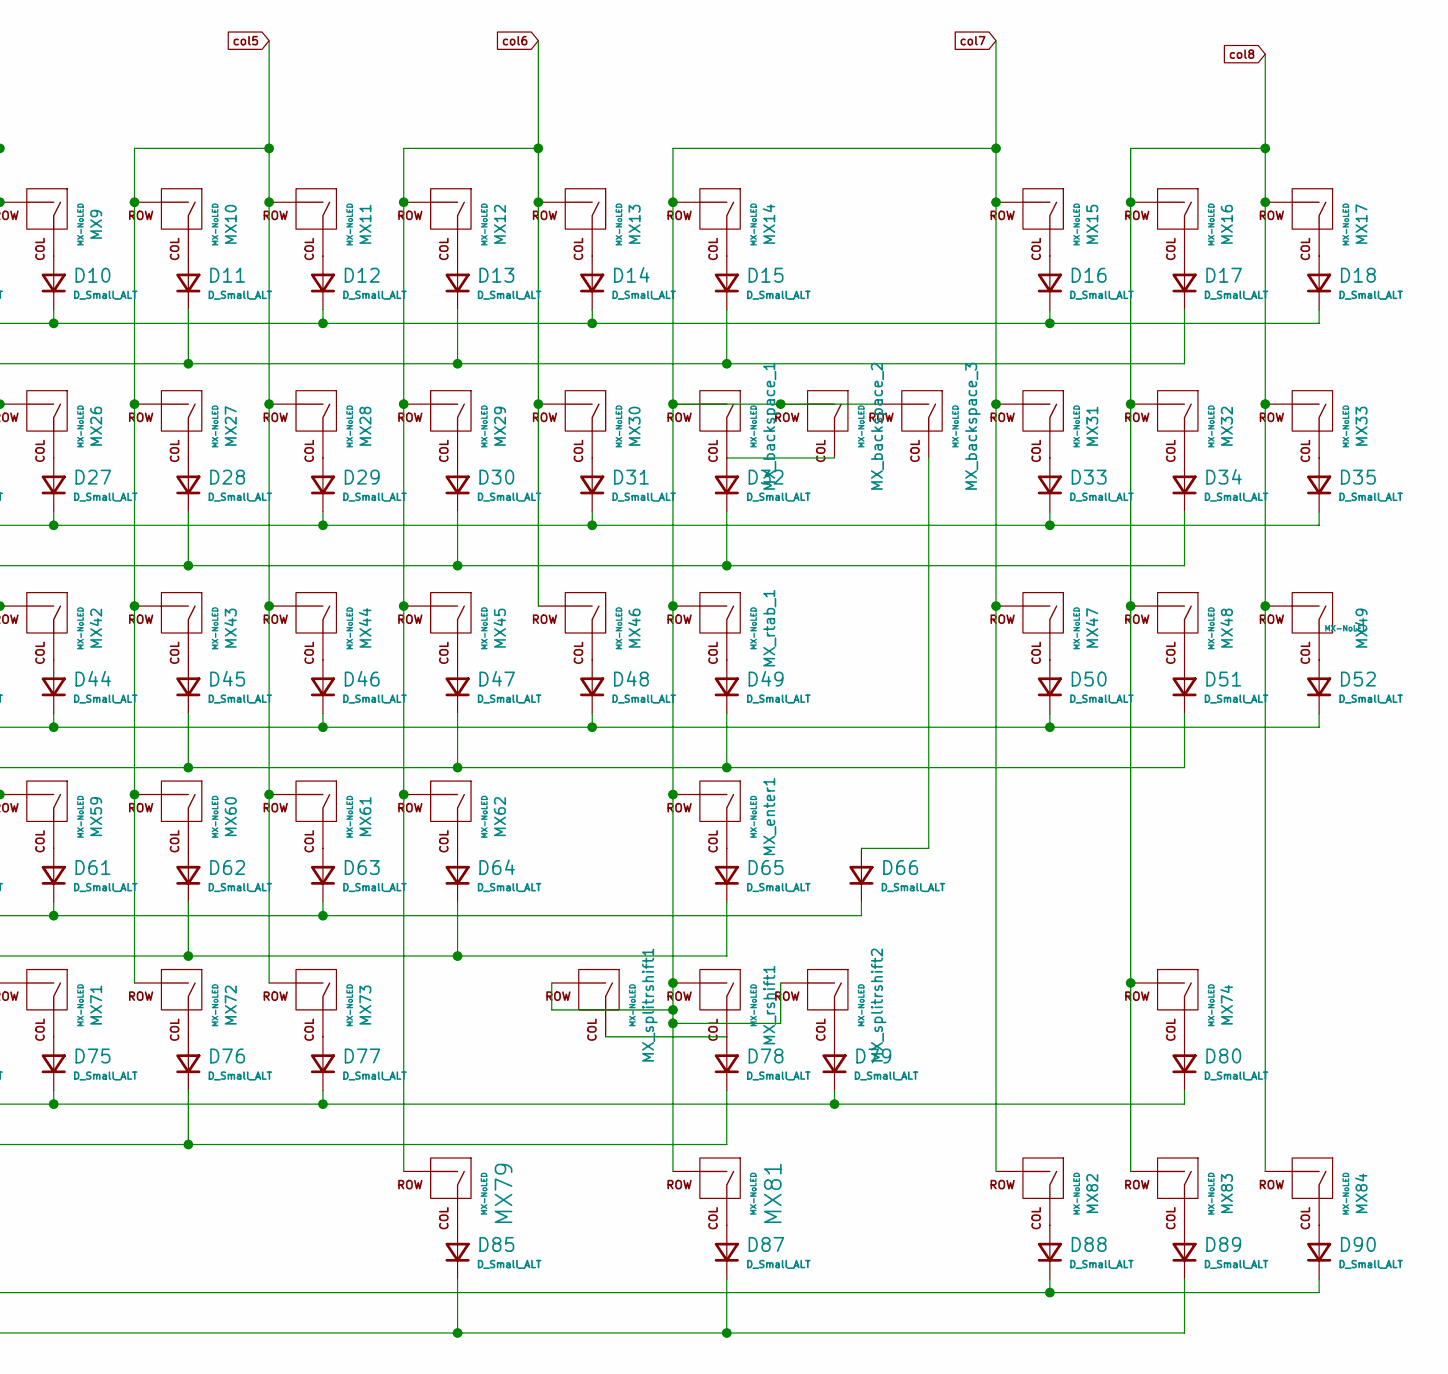
[picture p21: schematic matrix.kicad_sch, part in row 1, column 2]

Parts:
D2, D3, D4, D5, D6, D7, D8, D9, D10, D11, D12, D13, D14, D15, D16, D17, D18, D19, D20, D21, D22, D23, D24, D25, D26, D27, D28, D29, D30, D31, D32, D33, D34, D35, D36, D37, D38, D39, D40, D41, D42, D43, D44, D45, D46, D47, D48, D49, D50, D51, D52, D53, D54, D55, D56, D57, D58, D59, D60, D61, D62, D63, D64, D65, D66, D67, D68, D69, D70, D71, D72, D73, D74, D75, D76, D77, D78, D79, D80, D81, D83, D84, D85, D87, D88, D89, D90: D_Small_ALT; D_SOD-123
MX1, MX2, MX3, MX4, MX5, MX6, MX7, MX8, MX9, MX10, MX11, MX12, MX13, MX14, MX15, MX16, MX17, MX18, MX19, MX20, MX21, MX22, MX23, MX24, MX25, MX26, MX27, MX28, MX29, MX30, MX31, MX32, MX33, MX35, MX36, MX37, MX38, MX39, MX40, MX41, MX42, MX43, MX44, MX45, MX46, MX47, MX48, MX49, MX52, MX53, MX54, MX55, MX56, MX57, MX58, MX59, MX60, MX61, MX62, MX64, MX65, MX66, MX67, MX68, MX69, MX70, MX71, MX72, MX73, MX74, MX82, MX83, MX84: MX-NoLED; MXOnly-1U-Hotswap
MX34, MX75, MX77, MX79, MX81: MX-NoLED; MXOnly-1.5U-Hotswap
MX50, MX51: MX-NoLED; MXOnly-1.75U-Hotswap
MX63: MX-NoLED; MXOnly-2.25U-Hotswap
MX78: MX-NoLED; MXOnly-7U-Hotswap-ReversedStabilizers
MX_backspace_1: MX-NoLED; MXOnly-2U-Hotswap
MX_backspace_2, MX_backspace_3: MX-NoLED; MXOnly-1U-Hotswap
MX_enter1: MX-NoLED; MXOnly-2.25U-Hotswap-ReversedStabilizers
MX_rshift1: MX-NoLED; MXOnly-2.75U-Hotswap
MX_rtab_1: MX-NoLED; MXOnly-1.5U-Hotswap
MX_splitrshift1: MX-NoLED; MXOnly-1.75U-Hotswap
MX_splitrshift2: MX-NoLED; MXOnly-1U-Hotswap

Connections:
unnamed: D2.2 (A), MX1.1 (COL)
unnamed: D3.2 (A), MX2.1 (COL)
unnamed: D4.2 (A), MX3.1 (COL)
unnamed: D5.2 (A), MX4.1 (COL)
unnamed: D6.2 (A), MX5.1 (COL)
unnamed: D7.2 (A), MX6.1 (COL)
unnamed: D8.2 (A), MX7.1 (COL)
unnamed: D9.2 (A), MX8.1 (COL)
unnamed: D10.2 (A), MX9.1 (COL)
unnamed: D11.2 (A), MX10.1 (COL)
unnamed: D12.2 (A), MX11.1 (COL)
unnamed: D13.2 (A), MX12.1 (COL)
unnamed: D14.2 (A), MX13.1 (COL)
unnamed: D15.2 (A), MX14.1 (COL)
unnamed: D16.2 (A), MX15.1 (COL)
unnamed: D17.2 (A), MX16.1 (COL)
unnamed: D18.2 (A), MX17.1 (COL)
unnamed: D19.2 (A), MX18.1 (COL)
unnamed: D20.2 (A), MX19.1 (COL)
unnamed: D21.2 (A), MX20.1 (COL)
unnamed: D22.2 (A), MX21.1 (COL)
unnamed: D23.2 (A), MX22.1 (COL)
unnamed: D24.2 (A), MX23.1 (COL)
unnamed: D25.2 (A), MX24.1 (COL)
unnamed: D26.2 (A), MX25.1 (COL)
unnamed: D27.2 (A), MX26.1 (COL)
unnamed: D28.2 (A), MX27.1 (COL)
unnamed: D29.2 (A), MX28.1 (COL)
unnamed: D30.2 (A), MX29.1 (COL)
unnamed: D31.2 (A), MX30.1 (COL)
unnamed: D32.2 (A), MX_backspace_1.1 (COL), MX_backspace_2.1 (COL)
unnamed: D33.2 (A), MX31.1 (COL)
unnamed: D34.2 (A), MX32.1 (COL)
unnamed: D35.2 (A), MX33.1 (COL)
unnamed: D36.2 (A), MX34.1 (COL)
unnamed: D37.2 (A), MX35.1 (COL)
unnamed: D38.2 (A), MX36.1 (COL)
unnamed: D39.2 (A), MX37.1 (COL)
unnamed: D40.2 (A), MX38.1 (COL)
unnamed: D41.2 (A), MX39.1 (COL)
unnamed: D42.2 (A), MX40.1 (COL)
unnamed: D43.2 (A), MX41.1 (COL)
unnamed: D44.2 (A), MX42.1 (COL)
unnamed: D45.2 (A), MX43.1 (COL)
unnamed: D46.2 (A), MX44.1 (COL)
unnamed: D47.2 (A), MX45.1 (COL)
unnamed: D48.2 (A), MX46.1 (COL)
unnamed: D49.2 (A), MX_rtab_1.1 (COL)
unnamed: D50.2 (A), MX47.1 (COL)
unnamed: D51.2 (A), MX48.1 (COL)
unnamed: D52.2 (A), MX49.1 (COL)
unnamed: D53.2 (A), MX50.1 (COL), MX51.2 (ROW)
unnamed: D54.2 (A), MX52.1 (COL)
unnamed: D55.2 (A), MX53.1 (COL)
unnamed: D56.2 (A), MX54.1 (COL)
unnamed: D57.2 (A), MX55.1 (COL)
unnamed: D58.2 (A), MX56.1 (COL)
unnamed: D59.2 (A), MX57.1 (COL)
unnamed: D60.2 (A), MX58.1 (COL)
unnamed: D61.2 (A), MX59.1 (COL)
unnamed: D62.2 (A), MX60.1 (COL)
unnamed: D63.2 (A), MX61.1 (COL)
unnamed: D64.2 (A), MX62.1 (COL)
unnamed: D65.2 (A), MX_enter1.1 (COL)
unnamed: D66.2 (A), MX_backspace_3.1 (COL)
unnamed: D67.2 (A), MX63.1 (COL)
unnamed: D68.2 (A), MX64.1 (COL)
unnamed: D69.2 (A), MX65.1 (COL)
unnamed: D70.2 (A), MX66.1 (COL)
unnamed: D71.2 (A), MX67.1 (COL)
unnamed: D72.2 (A), MX68.1 (COL)
unnamed: D73.2 (A), MX69.1 (COL)
unnamed: D74.2 (A), MX70.1 (COL)
unnamed: D75.2 (A), MX71.1 (COL)
unnamed: D76.2 (A), MX72.1 (COL)
unnamed: D77.2 (A), MX73.1 (COL)
unnamed: D78.2 (A), MX_rshift1.1 (COL), MX_splitrshift1.1 (COL)
unnamed: D79.2 (A), MX_splitrshift2.1 (COL)
unnamed: D80.2 (A), MX74.1 (COL)
unnamed: D81.2 (A), MX75.1 (COL)
unnamed: D83.2 (A), MX77.1 (COL)
unnamed: D84.2 (A), MX78.1 (COL)
unnamed: D85.2 (A), MX79.1 (COL)
unnamed: D87.2 (A), MX81.1 (COL)
unnamed: D88.2 (A), MX82.1 (COL)
unnamed: D89.2 (A), MX83.1 (COL)
unnamed: D90.2 (A), MX84.1 (COL)
col0: MX1.2 (ROW), MX18.2 (ROW), MX34.2 (ROW), MX50.2 (ROW), MX51.1 (COL), MX63.2 (ROW), MX75.2 (ROW)
col1: MX2.2 (ROW), MX3.2 (ROW), MX19.2 (ROW), MX20.2 (ROW), MX35.2 (ROW), MX36.2 (ROW), MX52.2 (ROW), MX53.2 (ROW), MX64.2 (ROW), MX65.2 (ROW), MX77.2 (ROW)
col2: MX4.2 (ROW), MX5.2 (ROW), MX21.2 (ROW), MX22.2 (ROW), MX37.2 (ROW), MX38.2 (ROW), MX54.2 (ROW), MX55.2 (ROW), MX66.2 (ROW), MX67.2 (ROW)
col3: MX6.2 (ROW), MX7.2 (ROW), MX23.2 (ROW), MX24.2 (ROW), MX39.2 (ROW), MX40.2 (ROW), MX56.2 (ROW), MX57.2 (ROW), MX68.2 (ROW), MX69.2 (ROW), MX78.2 (ROW)
col4: MX8.2 (ROW), MX9.2 (ROW), MX25.2 (ROW), MX26.2 (ROW), MX41.2 (ROW), MX42.2 (ROW), MX58.2 (ROW), MX59.2 (ROW), MX70.2 (ROW), MX71.2 (ROW)
col5: MX10.2 (ROW), MX11.2 (ROW), MX27.2 (ROW), MX28.2 (ROW), MX43.2 (ROW), MX44.2 (ROW), MX60.2 (ROW), MX61.2 (ROW), MX72.2 (ROW), MX73.2 (ROW)
col6: MX12.2 (ROW), MX13.2 (ROW), MX29.2 (ROW), MX30.2 (ROW), MX45.2 (ROW), MX46.2 (ROW), MX62.2 (ROW), MX79.2 (ROW)
col7: MX14.2 (ROW), MX15.2 (ROW), MX31.2 (ROW), MX47.2 (ROW), MX81.2 (ROW), MX82.2 (ROW), MX_backspace_1.2 (ROW), MX_backspace_2.2 (ROW), MX_backspace_3.2 (ROW), MX_enter1.2 (ROW), MX_rshift1.2 (ROW), MX_rtab_1.2 (ROW), MX_splitrshift1.2 (ROW), MX_splitrshift2.2 (ROW)
col8: MX16.2 (ROW), MX17.2 (ROW), MX32.2 (ROW), MX33.2 (ROW), MX48.2 (ROW), MX49.2 (ROW), MX74.2 (ROW), MX83.2 (ROW), MX84.2 (ROW)
row0: D2.1 (K), D4.1 (K), D6.1 (K), D8.1 (K), D10.1 (K), D12.1 (K), D14.1 (K), D16.1 (K), D18.1 (K)
row1: D3.1 (K), D5.1 (K), D7.1 (K), D9.1 (K), D11.1 (K), D13.1 (K), D15.1 (K), D17.1 (K)
row2: D19.1 (K), D21.1 (K), D23.1 (K), D25.1 (K), D27.1 (K), D29.1 (K), D31.1 (K), D33.1 (K), D35.1 (K)
row3: D20.1 (K), D22.1 (K), D24.1 (K), D26.1 (K), D28.1 (K), D30.1 (K), D32.1 (K), D34.1 (K)
row4: D36.1 (K), D38.1 (K), D40.1 (K), D42.1 (K), D44.1 (K), D46.1 (K), D48.1 (K), D50.1 (K), D52.1 (K)
row5: D37.1 (K), D39.1 (K), D41.1 (K), D43.1 (K), D45.1 (K), D47.1 (K), D49.1 (K), D51.1 (K)
row6: D53.1 (K), D55.1 (K), D57.1 (K), D59.1 (K), D61.1 (K), D63.1 (K), D66.1 (K)
row7: D54.1 (K), D56.1 (K), D58.1 (K), D60.1 (K), D62.1 (K), D64.1 (K), D65.1 (K)
row8: D67.1 (K), D69.1 (K), D71.1 (K), D73.1 (K), D75.1 (K), D77.1 (K), D79.1 (K), D80.1 (K)
row9: D68.1 (K), D70.1 (K), D72.1 (K), D74.1 (K), D76.1 (K), D78.1 (K)
row10: D81.1 (K), D83.1 (K), D88.1 (K), D90.1 (K)
row11: D84.1 (K), D85.1 (K), D87.1 (K), D89.1 (K)
