bevinkbd/miscellaneous-calla/firmware/source/eccalla/config.h

/* Copyright 2023 Bevin
 *
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
 * You should have received a copy of the GNU General Public License
 * along with this program.  If not, see <http://www.gnu.org/licenses/>.
 */

#pragma once

#define MATRIX_ROWS 6
#define MATRIX_COLS 16

#define MATRIX_ROW_PINS {B12, B13, B0, B14, B15, A8}

#define AMUX_COUNT 2
#define AMUX_MAX_COLS_COUNT 8

#define AMUX_EN_PINS { B7, A6 }

#define AMUX_SEL_PINS { B6, B5, B4 }

#define AMUX_COL_CHANNELS_SIZES { 8, 8 }

#define AMUX_0_COL_CHANNELS {2, 1, 0, 3, 4, 6, 5, 7}

#define AMUX_1_COL_CHANNELS AMUX_0_COL_CHANNELS

#define AMUX_COL_CHANNELS AMUX_0_COL_CHANNELS, AMUX_1_COL_CHANNELS

#define DISCHARGE_PIN A4
#define ANALOG_PORT A3

/*#define DEBUG_MATRIX_SCAN_RATE*/

#define RGB_MATRIX_FRAMEBUFFER_EFFECTS
#define RGB_MATRIX_KEYPRESSES
#define VIALRGB_NO_DIRECT
#define DRIVER_LED_TOTAL 16

/* VIAL Specific */
#define DYNAMIC_KEYMAP_LAYER_COUNT 3
#define VIAL_COMBO_ENTRIES 4
#define VIAL_TAP_DANCE_ENTRIES 4

#define DISCHARGE_PIN A4
#define ANALOG_PORT A3

/* Actuation Settings */

#define DEFAULT_ACTUATION_MODE 0
#define DEFAULT_MODE_0_ACTUATION_LEVEL 550
#define DEFAULT_MODE_0_RELEASE_LEVEL 500
#define DEFAULT_MODE_1_INITIAL_DEADZONE_OFFSET DEFAULT_MODE_0_ACTUATION_LEVEL
#define DEFAULT_MODE_1_ACTUATION_OFFSET 70
#define DEFAULT_MODE_1_RELEASE_OFFSET 70
#define DEFAULT_EXTREMUM 1023
#define EXPECTED_NOISE_FLOOR 0
#define NOISE_FLOOR_THRESHOLD 50
#define BOTTOMING_CALIBRATION_THRESHOLD 100
#define DEFAULT_NOISE_FLOOR_SAMPLING_COUNT 30
#define DEFAULT_BOTTOMING_READING 1023
#define DEFAULT_CALIBRATION_STARTER true

#define DISCHARGE_TIME 10

// #define DEBUG_MATRIX_SCAN_RATE
#define EECONFIG_KB_DATA_SIZE 201

/* Mechanical locking support. Use KC_LCAP, KC_LNUM or KC_LSCR instead in keymap */
#define LOCKING_SUPPORT_ENABLE

/* Locking resynchronize hack */
#define LOCKING_RESYNC_ENABLE
