bevinkbd/miscellaneous-calla/(commit log)

2024-04-28 upload custom Topre plates
    [metal_topre_2023_08_19_splitBS+splitRS.dxf, metal_topre_2023_08_19_splitBS.dxf, metal_topre_2023_08_19_splitRS.dxf]
2024-04-28 added alps +cleaning up
    [EC_Rev2.csv, EC_Rev2.kicad_sch, alps_2023_08_19.dxf, alps_2023_08_19_splitbs.dxf, alps_2023_08_19_splitrs+split_bs.dxf, alps_2023_08_19_splitrs.dxf, analog.kicad_sch, calla.csv]
2024-04-28 case sensitive fix
    [EC_Rev2.csv, EC_Rev2.kicad_sch, alps_2023_08_19.dxf, alps_2023_08_19_splitbs.dxf, alps_2023_08_19_splitrs+split_bs.dxf, alps_2023_08_19_splitrs.dxf, analog.kicad_sch, calla.csv]
2024-04-28 fix finished
    [EC_Rev2.kicad_sch, alps_2023_08_19.dxf, alps_2023_08_19_splitbs.dxf, alps_2023_08_19_splitrs+split_bs.dxf, alps_2023_08_19_splitrs.dxf, analog.kicad_sch, foam.dxf, hscalla.kicad_sch]
2024-05-03 updated screws + readme
2024-05-08 updated folder names
    [alps_2023_08_19.dxf, alps_2023_08_19_splitbs.dxf, alps_2023_08_19_splitrs+split_bs.dxf, alps_2023_08_19_splitrs.dxf, metal_MX_2023_08_19.dxf, metal_topre_2023_08_19.dxf, metal_topre_2023_08_19_splitBS+splitRS.dxf, metal_topre_2023_08_19_splitBS.dxf]
2024-06-04 screws.txt changed
    added some descriptions to screws
